piit79/42keebs-kicad/README.md

# 42keebs-kicad
KiCad symbols/footprints used in 42. Keebs (42keebs.eu) projects
