piit79/42keebs-kicad/graphics/Powered_by_QMK-bw.png

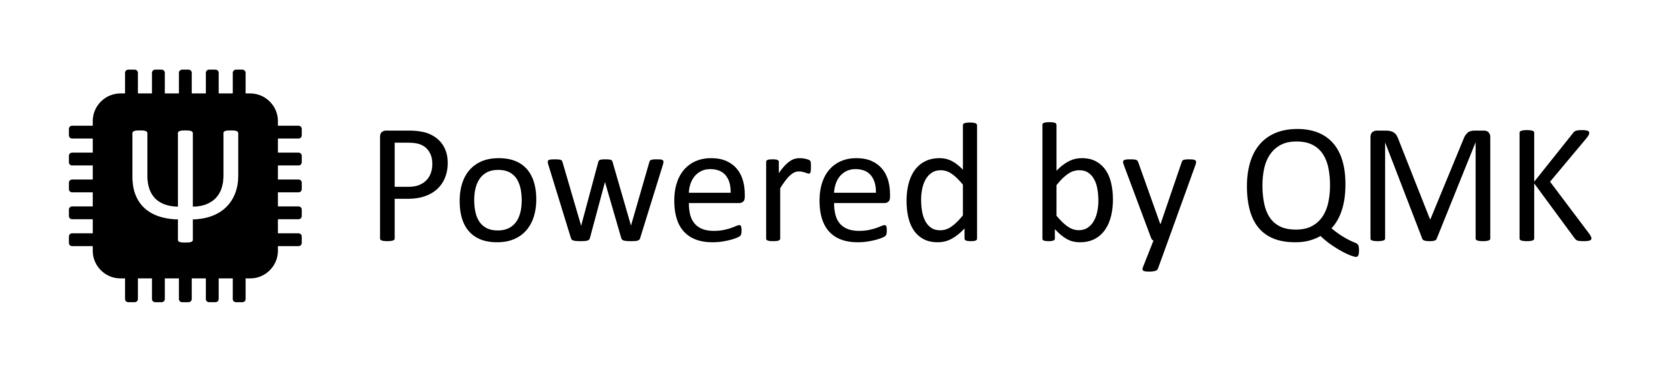
graphics/Powered_by_QMK-bw.png
