piit79/42keebs-kicad/graphics/Powered_by_QMK-Fw-bw.png

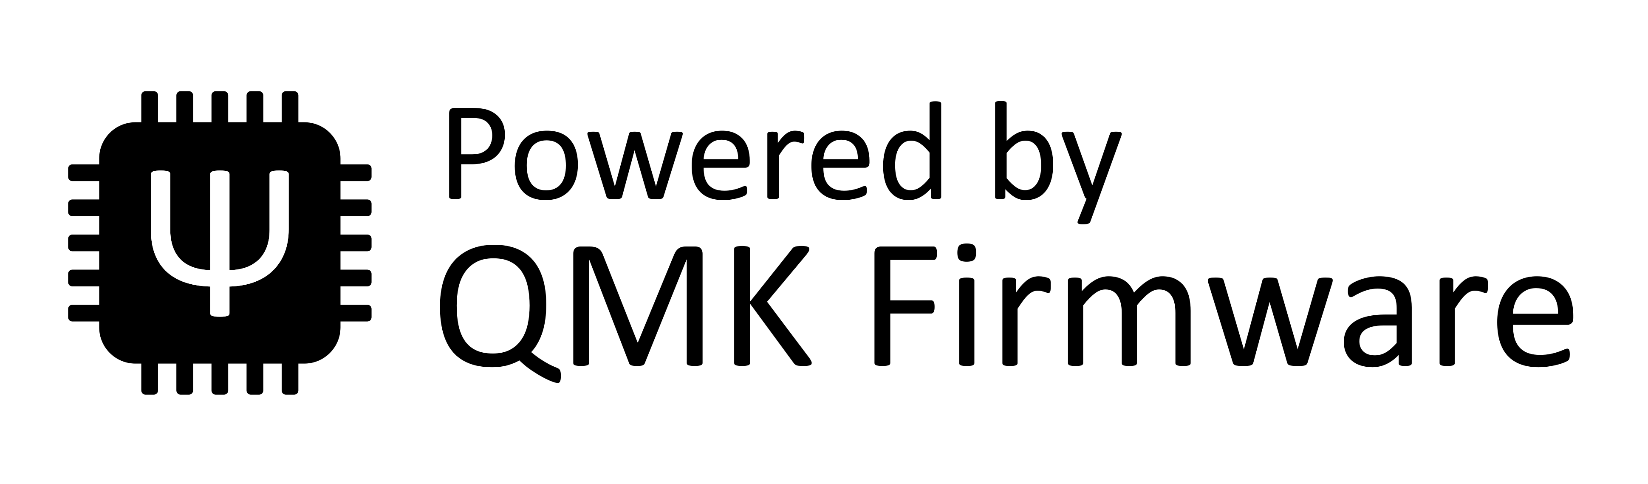
graphics/Powered_by_QMK-Fw-bw.png
