piit79/42keebs-kicad/3dmodels/KXT311LHS.step

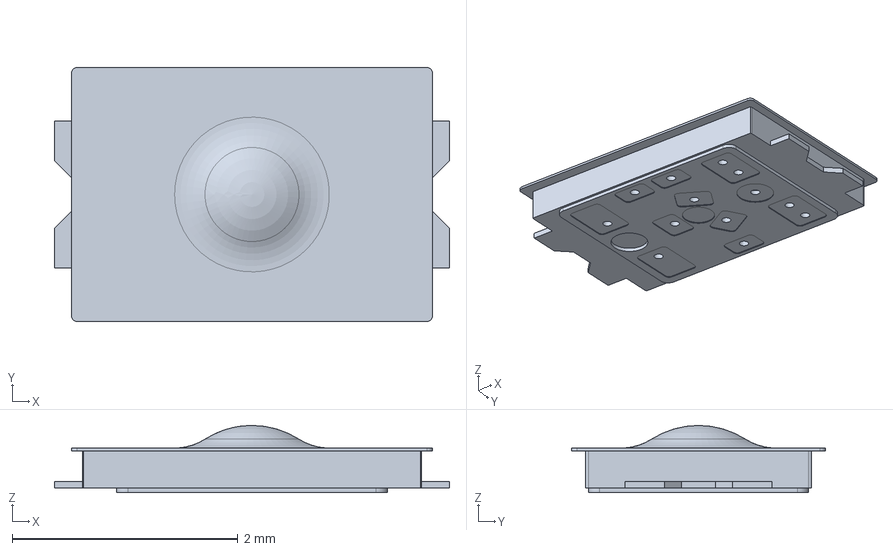
[picture p3: CAD file, 2023-10-10]
3dmodels/KXT311LHS.step
3.50 x 2.25 x 0.595 mm
