piit79/42keebs-kicad/3dmodels/USB-C_connector_horizontal_inboard.step

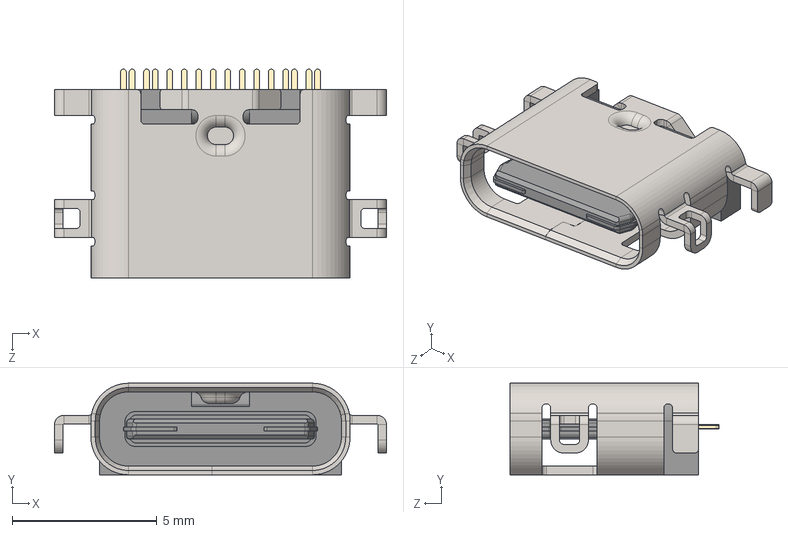
[picture p4: CAD file, 2023-06-27]
3dmodels/USB-C_connector_horizontal_inboard.step
11.5 x 3.16 x 7.20 mm
USB-C inboard metal
USB-C plastic
