piit79/42keebs-kicad/3dmodels/YS-SK6812MINI-E.step

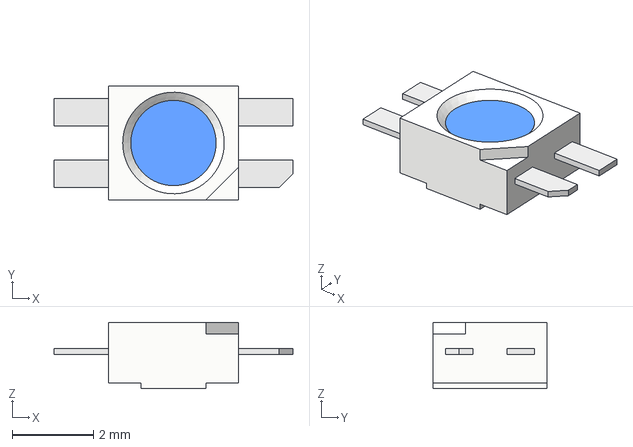
[picture p5: CAD file, 2023-02-28]
3dmodels/YS-SK6812MINI-E.step
5.88 x 2.80 x 1.63 mm
