piit79/42keebs-kicad/3dmodels/DFN-8_4x3.step

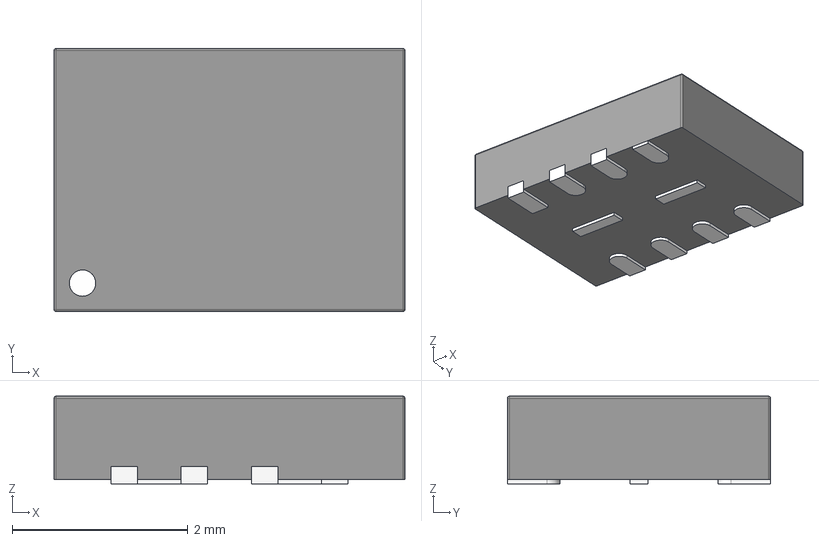
[picture p6: CAD file, 2022-08-18]
3dmodels/DFN-8_4x3.step
4.00 x 3.00 x 1.00 mm
