piit79/42keebs-kicad/3dmodels/HRO-TYPE-C-31-M-14.step

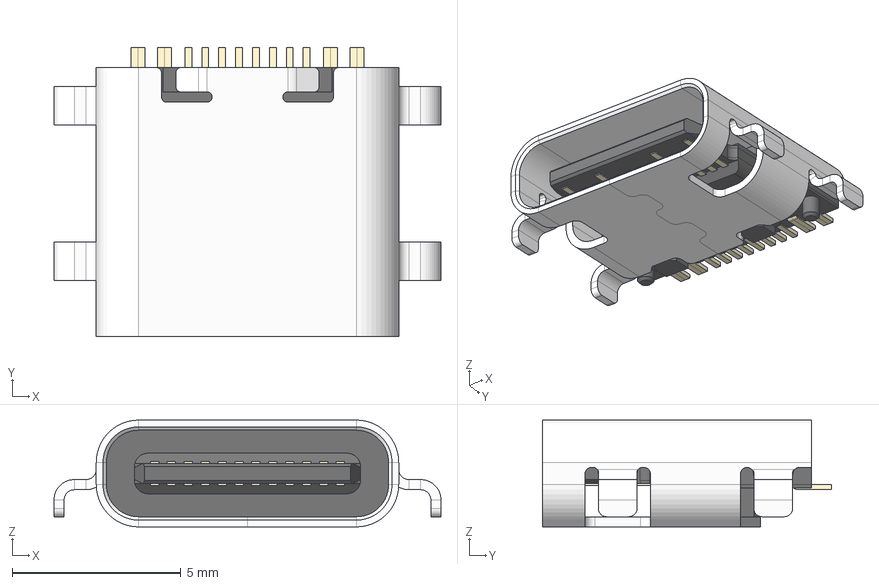
[picture p7: CAD file, 2022-08-17]
3dmodels/HRO-TYPE-C-31-M-14.step
11.5 x 8.56 x 3.16 mm
Shroud
Plastic Body & Connector
