piit79/42keebs-kicad/3dmodels/HRO-TYPE-C-31-M-13.step

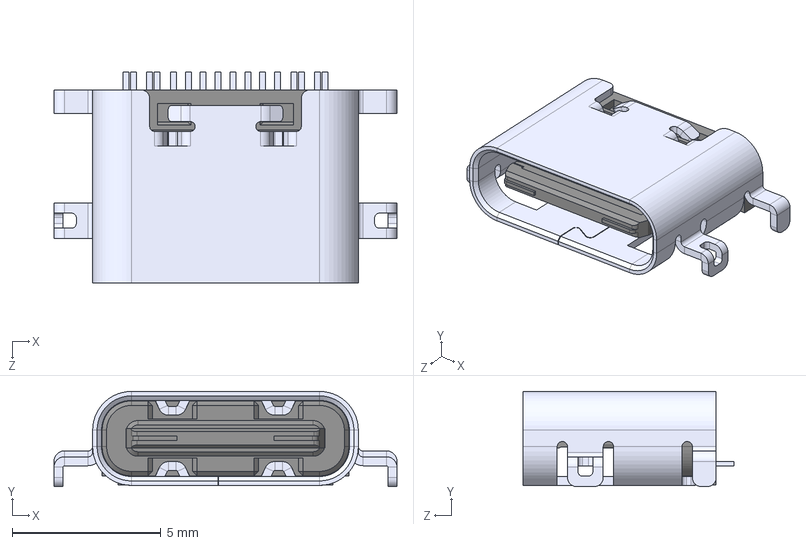
[picture p8: CAD file, 2022-08-16]
3dmodels/HRO-TYPE-C-31-M-13.step
11.5 x 3.20 x 7.10 mm
