piit79/42keebs-kicad/3dmodels/Molex-2169900001.stp

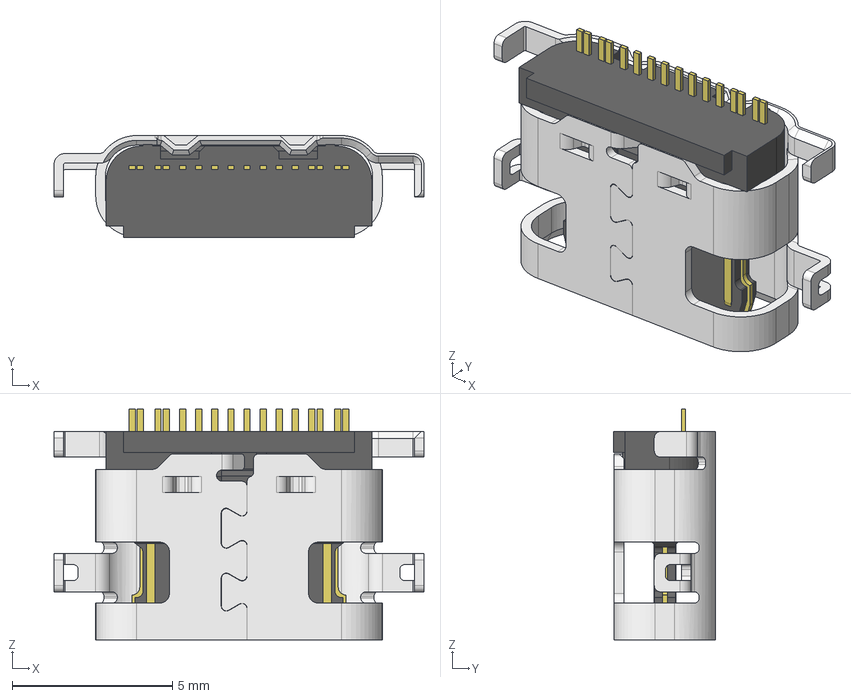
[picture p9: CAD file, 2022-08-16]
3dmodels/Molex-2169900001.stp
11.5 x 3.18 x 7.20 mm
