piit79/42keebs-kicad/3dmodels/MBK_Keycap_2u_Black.step

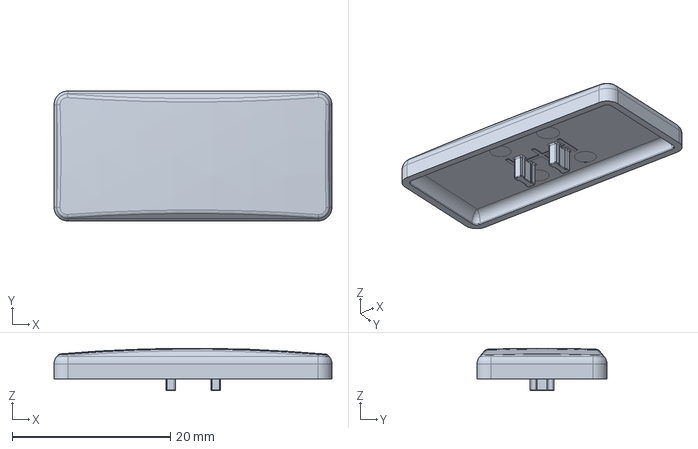
[picture p10: CAD file, 2022-07-05]
3dmodels/MBK_Keycap_2u_Black.step
35.2 x 16.4 x 5.38 mm
