piit79/42keebs-kicad/3dmodels/MBK_Keycap_1u_Homing_Black.step

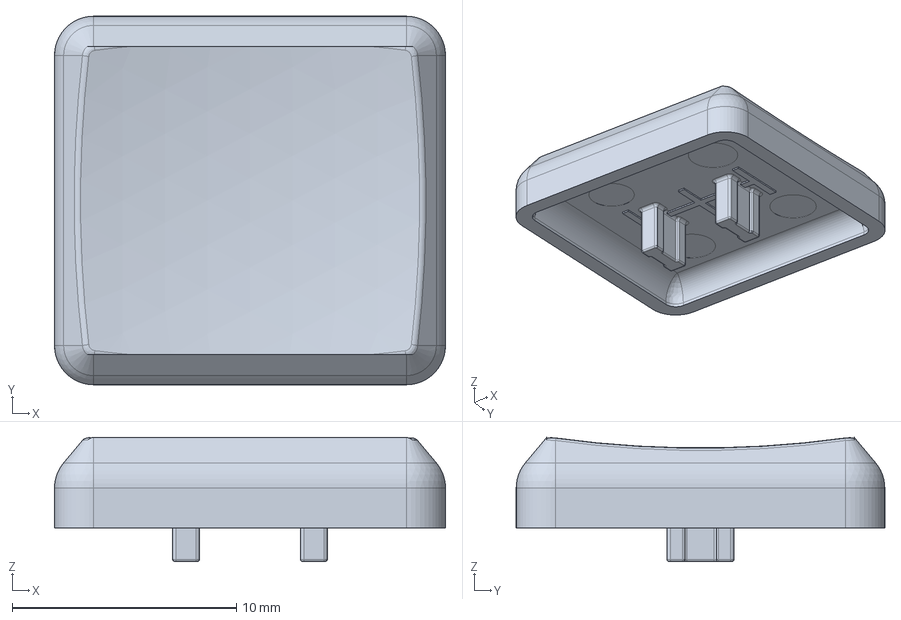
[picture p11: CAD file, 2022-07-05]
3dmodels/MBK_Keycap_1u_Homing_Black.step
17.5 x 16.4 x 5.54 mm
