piit79/42keebs-kicad/3dmodels/MBK_Keycap_1.5u_Black.step

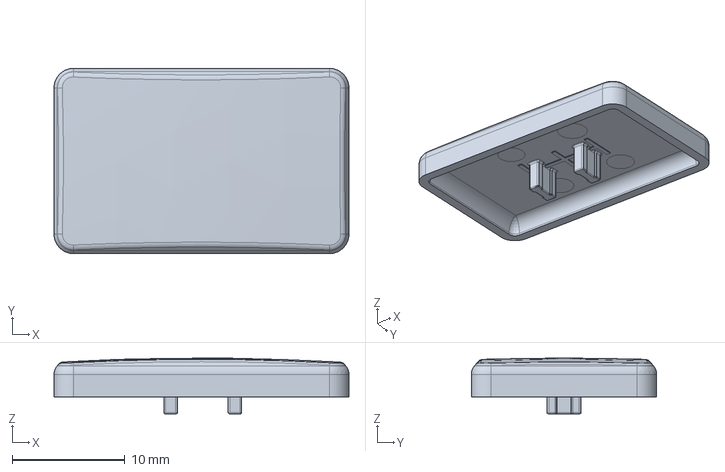
[picture p12: CAD file, 2022-07-05]
3dmodels/MBK_Keycap_1.5u_Black.step
26.2 x 16.4 x 4.94 mm
