piit79/42keebs-kicad/3dmodels/MBK_Keycap_1u_Black.step

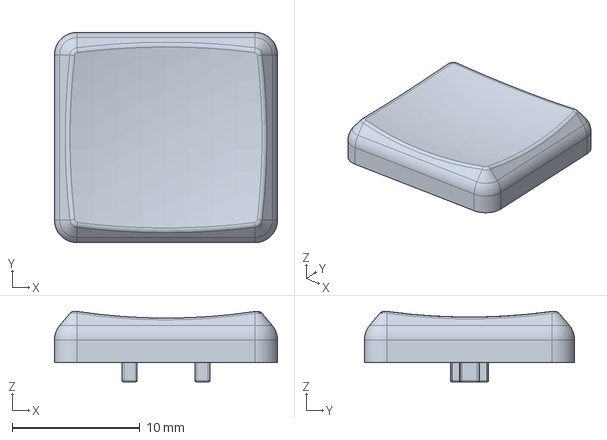
[picture p13: CAD file, 2022-07-05]
3dmodels/MBK_Keycap_1u_Black.step
17.4 x 16.4 x 5.52 mm
