piit79/42keebs-kicad/3dmodels/Kailh_Choc_Low_Profile_Switch_Red.step

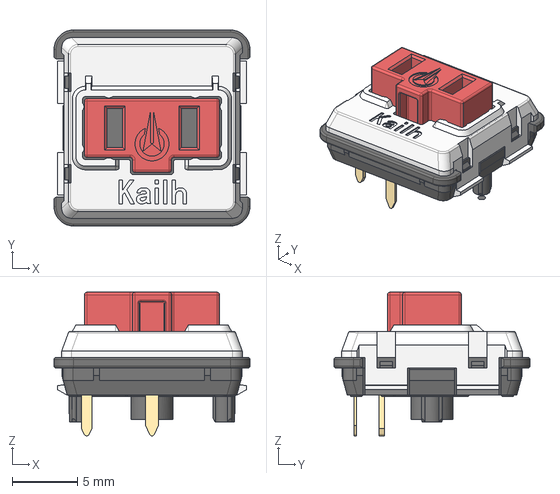
[picture p14: CAD file, 2022-07-05]
3dmodels/Kailh_Choc_Low_Profile_Switch_Red.step
15.0 x 15.0 x 11.0 mm
