piit79/42keebs-kicad/3dmodels/Kailh_LP_Choc_Burnt_Orange.step

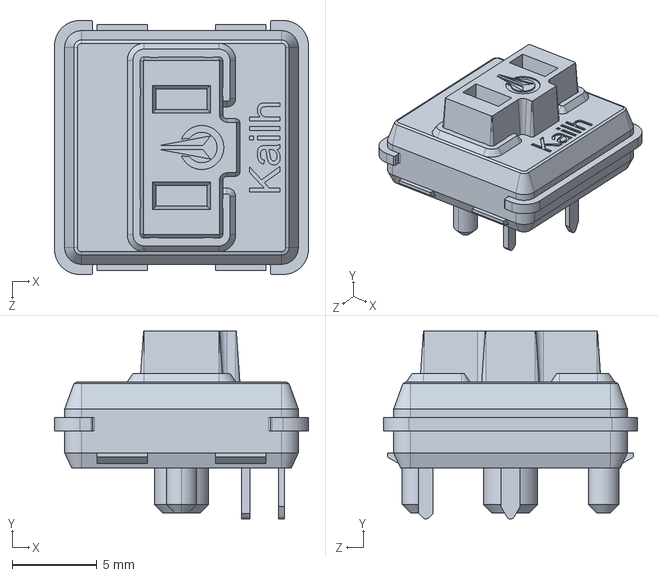
[picture p15: CAD file, 2022-07-05]
3dmodels/Kailh_LP_Choc_Burnt_Orange.step
15.0 x 11.1 x 15.0 mm
