piit79/42keebs-kicad/3dmodels/Kailh_socket_PG1350.step

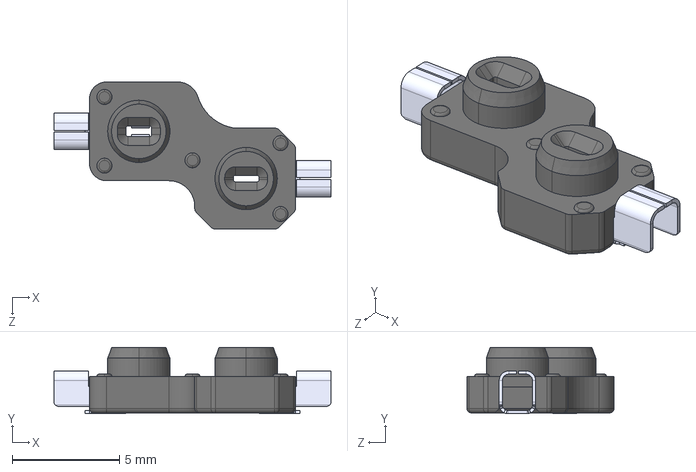
[picture p17: CAD file, 2022-06-28]
3dmodels/Kailh_socket_PG1350.step
12.9 x 3.09 x 6.85 mm
pin x 2
socket
