piit79/42keebs-kicad/3dmodels/D_DO-35_SOD27_P5.08mm_Horizontal_Improved.step

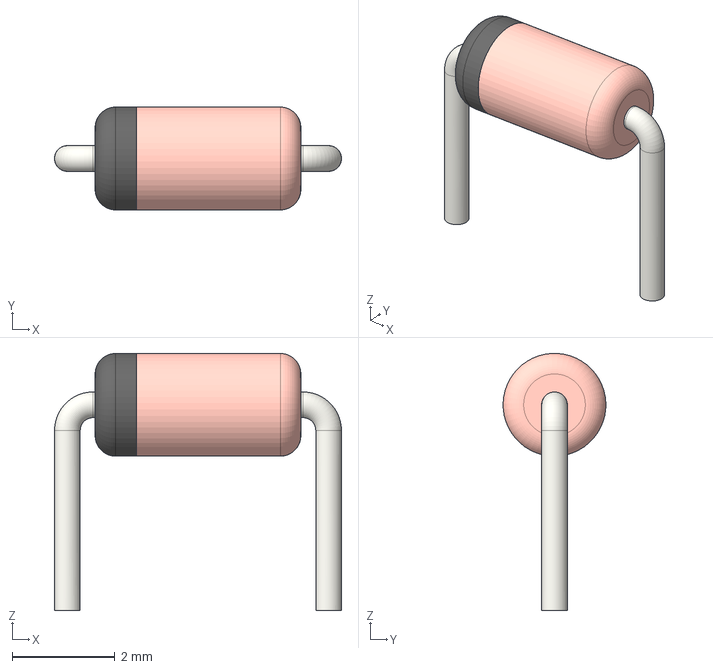
[picture p18: CAD file, 2022-06-27]
3dmodels/D_DO-35_SOD27_P5.08mm_Horizontal_Improved.step
5.58 x 2.00 x 5.00 mm
