piit79/42keebs-kicad/(commit log)

2022-03-31 Add a bunch of footprints
2022-03-31 Add rotary encoder footprint for MX switch
2022-03-31 Add 'Powered by QMK' logos
2022-04-01 Add QMK logo symbol; update 42. Keebs logo symbol & footprint
2022-04-05 Footprints: Update 2u MX/Choc, add "opposing" variants
2022-04-14 Add the GCT-USB4085 USB-C socket footprint with offset pads
2022-06-22 Add Kailh MX hotswap socket footprints
2022-06-22 Add THT DO-35 diode footprint
2022-06-22 Add combined Switch/Rotary Encoder symbol
2022-06-22 Improve combined Kailh MX Socket/Encoder footprint
2022-06-23 Add polyfuse footprint
2022-06-24 Move texts on Kail MX Socket footprint to Fab layer
2022-06-24 Fix shift in Kailh Socket/EC11 footprint; make MP/pin hole PTH
2022-06-24 Add smaller DO-35 / Zener footprints
2022-06-25 Add PJ-320A footprint
    Adapted from https://github.com/foostan/kbd/
2022-06-27 Add 3D models for D_DO-35_SOD27_P5.08 and USB4085
    [D_DO-35_SOD27_P5.08mm_Horizontal_Improved.step]
2022-06-28 Add footprint and 3D model for Kailh Choc PG1350 socket
    [Kailh_socket_PG1350.step]
2022-06-29 Add Pro Micro 3D model
    Courtesy of the kbd library: https://github.com/foostan/kbd
    [ProMicro.step]
2022-06-29 Add SOD-123 diode footprints
2022-07-05 Add 3D model of Kailh Choc switch
    Courtesy of Scottua via GrabCAD: https://grabcad.com/library/kailh-low-profile-mechanical-keyboard-switch-1
    [Kailh_LP_Choc_Burnt_Orange.step]
2022-07-05 Add another 3D model of Kailh Choc switch
    Courtesy of Stephan Park via GrabCAD: https://grabcad.com/library/kailh-choc-low-profile-switch-1
    Modified to hide the PCB fragment and diode legs, and changed colour of the stem from brown to red
    [Kailh_Choc_Low_Profile_Switch_Red.step]
2022-07-05 Add 3D models for MBK Choc keycaps
    Courtesy of darryldh via 3DMixers: https://3dmixers.com/m/63763-mbk-choc-low-profile-keycaps
    Modified to change the colour from red to black
    [MBK_Keycap_1.5u_Black.step, MBK_Keycap_1u_Black.step, MBK_Keycap_1u_Homing_Black.step, MBK_Keycap_2u_Black.step]
2022-07-05 Update Kailh socket footprints with a socket 3D model; add versions with switch and MBK cap
2022-07-11 Edit small ZD footprint courtyard to match resistor
2022-07-11 Fix silkscreen on Kailh MX Socket footprint; add a new one with 3535 RGB module outline
2022-07-11 Move Kailh MX Socket 2u footpring to B.Cu by default and fix silkscreen
2022-07-11 Fix 3D models in fixed/modded Kailh MX socket footprints
2022-08-16 Add footprints and 3D models for Molex-216990/GCT-USB45xx/HRO-TYPE-C-31-M-13
    [HRO-TYPE-C-31-M-13.step, Molex-2169900001.stp]
2022-08-16 Add USON-8 4x3 mm footprint
2022-08-16 Add footprints for Pro Micro / Elite-C-style headers
2022-08-17 Add footprint/3D model for HRO-TYPE-C-31-M-13
    Footprint adapted & modified from https://github.com/jenschr/USB-C-Connectors
    3D model courtesy of https://grabcad.com/library/hro-usb-type-c-31-m-14-1
    [HRO-TYPE-C-31-M-14.step]
2022-08-18 Add a 3D model of DFN-8 4x3 P0.8 a.k.a. USON-8 4x3 package
    Courtesy of https://grabcad.com/library/dfn-and-tson-packages-1
    [DFN-8_4x3.step]
2022-08-25 Fix USB4085 USB-C socket footprint silkscreen clipped by solder mask
2022-08-25 Add USB Type-C socket symbol for USB4085
2022-08-26 Copy OLED symbol/footprint from foostan's kbd library
2022-08-28 Update OLED footprint to have double-sided pads
2022-08-28 Fix the CNC encoder footprint mounting holes
2022-09-18 Add a footprint for DFN-8 3x2 mm a.k.a. USON-8 3x3
2022-09-18 Update Molex 216990/GCT-USB45xx/HRO-TYPE-C-31-M-13x footprint
2022-10-13 Add symbol and footprint for the Frood 2x13+5 pin socket
2023-02-09 Fix D+ label on the Frood pin header symbol
2023-02-26 Add symbol and footprints for the Frood
2023-02-26 Add combined THT/SOD-123F diode footprint
2023-02-28 Rotate Frood footprint GND pads by 45 degrees for nicer thermal relief spokes
2023-02-28 Add/set 3D model for the SK6812 MINI-E RGB LED
    [YS-SK6812MINI-E.step]
2023-03-08 Add footprint for a 3 mm standoff through hole
2023-06-01 Add dual-sided vertially-aligned footprint for the Frood
2023-06-27 Add 3D model for mid-mounted USB-C socket and assign it to the footprint
    [USB-C_connector_horizontal_inboard.step]
2023-06-27 Add 3D model to the USON-8 4x3mm P0.8mm footprint
2023-07-18 Add Kailh Choc V1 socket footprint with mid plate cutouts
2023-07-18 Add combined Kailh MX + Choc V1 socket footprint
2023-10-10 Add 3D model for the KXT3 micro push button
    [KXT311LHS.step]
2023-10-10 Add footprint for a small two way 0.8 x 1 mm solder jumper
2024-01-02 Add new 2x13+5 Frood pin header footprint
2024-01-02 Add a modified mid-mounted USB-C socket for the Frood
    It has a 3.7 mm vertical offset for correct alignment
    during JLCPCB assembly
2024-01-02 Add small 2-pos bridged solder jumper footprint
2024-01-02 Add SW_SPST_CK_KXT3 footprint with the 3D model assigned
2024-01-03 Add reversible Kailh Choc hotswap socket footprint with cutout outlines
2024-01-03 Update dual-sided vertially-aligned footprint for the Frood
    * Update instruction to "To the right / upside down
    * Remove solder mask from the pad side that's not supposed to be soldered
2024-01-03 Add reversible PJ-320A footprint with no sleeve pin
2024-02-22 Rename symmetric reversible TRRS footprint and add pin cutouts
2024-02-22 Add pin cutouts to the Frood 2x13+5 footprint
2024-02-22 Add 2x12+5 pin Frood footprint (no D+/D-)
2024-04-02 Add symbol for the GCT USB4085 USB Type-C socket
2024-05-31 Add footprint for a 6x3 THT micro switch
    Courtesy of https://github.com/diepala/cantor
2024-06-02 Add symbol and footprint for rotary encoder combined with hotswap switch in two units
2024-06-03 Add Frood footprint without the extra bottom I/O
    This is to prevent interference with the antenna on the nice!view
2024-06-03 Add Kailh MX hotswap socket footprint combined with an EC11 encoder
2024-06-03 Add 2u Kailh MX hotswap socket footprint rotated 180 degrees for 2x1u/1x2u layouts
2024-06-03 Update the Kailh MX hotswap socket footprint labels
2024-09-04 Add 2x13+5+3 pin combined footprints for the Frood/nice!nano
2024-09-04 Add alternative Kailh MX hotswap socket footprint with cutout
2024-09-04 Add footprint for the WS2812B/SK6812 (5050) RGB LED module
2024-09-04 Add footprint for the 6x3 THT push button
2024-10-07 Update the PJ-320A reversible symmetric footprint
2024-11-18 Update the Frood dual side-by-side footprint
2024-11-18 Update the reversible Kailh Choc V1 socket footprint with cutouts
2024-11-18 Update the reversible symmetric TRRS socket footprint
2024-11-18 Add WS2812B footprint with cutouts
2025-03-31 Add combined dual-sided footprint for Frood/nice!nano
2025-03-31 Add reversible Kailh MX socket footprint with cutouts
2025-03-31 Add double-sided wide battery contacts footprint
2025-03-31 Add footprints for single/double sided/shifted PCM12 SPDT switch with cutouts
2025-03-31 Add double-sided GCT USB4085 USB-C footprint with cutouts
